TannerHollis/WS2812-Controller/Board_Design/Outputs/Board_Design_3D_Model.png

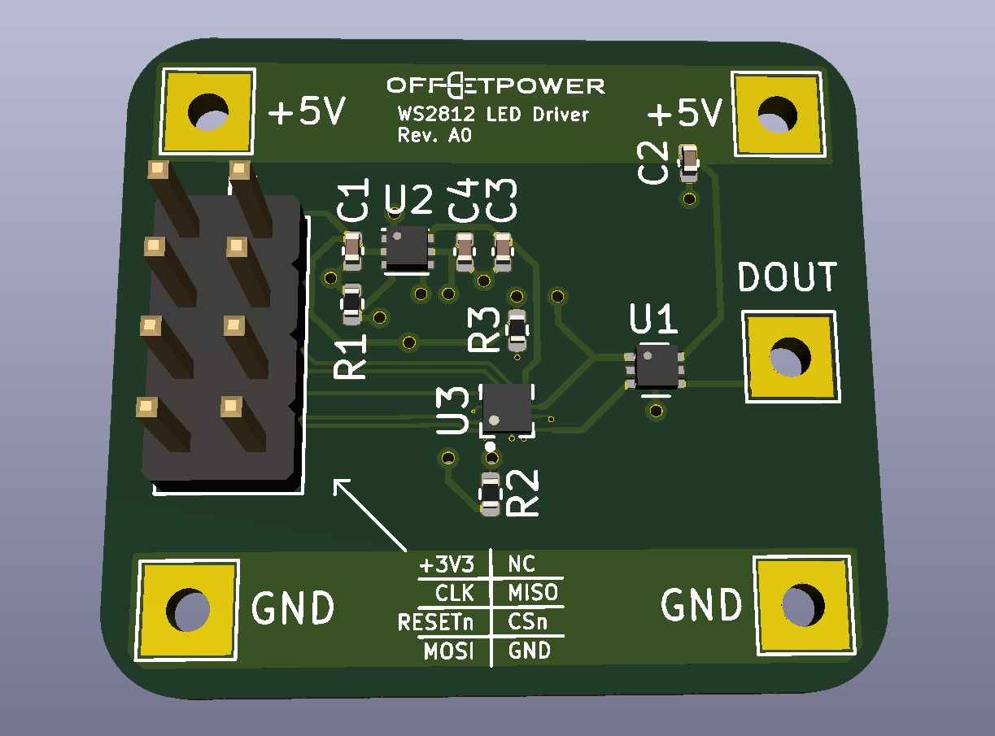
Board_Design/Outputs/Board_Design_3D_Model.png
