TannerHollis/WS2812-Controller/Images/ws2812_overview.png

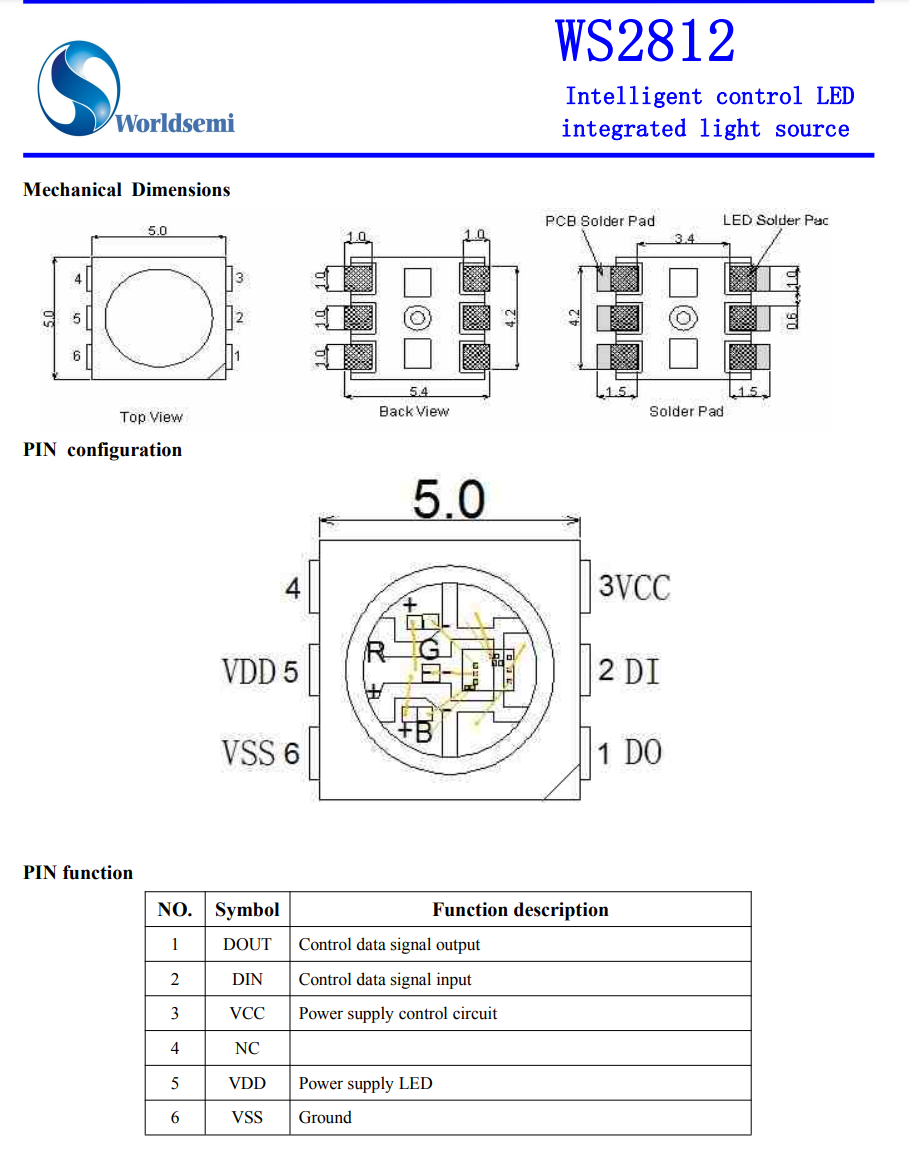
Images/ws2812_overview.png
