TannerHollis/WS2812-Controller/Board_Design/BOM-PCBWay.xlsx

 |  |  | WS2812 Driver BOM
Item # | *Designator | *Qty | Manufacturer | *Mfg Part # | Description / Value | *Package/Footprint | Type | Your Instructions / Notes
1 | C1, C3, C4 | 3 | Generic |  | 1U | C_0402_1005Metric | SMD
2 | C2 | 1 | Generic |  | 10U | C_0402_1005Metric | SMD
3 | J1 | 1 |  |  | 5Vin |  | SMD | DNP
4 | J2 | 1 |  |  | GNDin |  | SMD | DNP
5 | J3 | 1 |  |  | 5Vout |  | SMD | DNP
6 | J4 | 1 |  |  | DOUT |  | SMD | DNP
7 | J5 | 1 |  |  | GNDout |  | SMD | DNP
8 | J6 | 1 |  |  | INPUT |  | SMD | DNP
9 | J7, J8, J9, J10, J11, J12 | 6 |  |  | PogoPin |  | SMD | DNP
10 | R1, R2, R3 | 3 | Generic |  | 10K | C_0402_1005Metric | SMD
11 | U1 | 1 | 74LVC1T45Z6-7 | 74LVC1T45Z6-7 | Voltage Level Translator Bidirectional 1 Circuit 1 Channel - SOT-563 | SOT-563 | SMD
12 | U2 | 1 | Texas Instruments | TLV7111225DSER | Linear Voltage Regulator IC Positive Fixed 2 Output 200mA 6-WSON (1.5x1.5) | 6-WSON_1.5mmx1.5mm | SMD
13 | U3 | 1 | Lattice Semiconductor Corporation | ICE40UL640-SWG16ITR1K | series Field Programmable Gate Array (FPGA) IC 10 57344 640 16-XFBGA, WLCSP | 16-XFBGA, WLCSP | SMD
Need a quick and accurante quote? Need an efficient production? Please read SMT Ordering Necessary Files & Info in 1 minute. Thank you very much!
Click for Instructions on How to Create a BOM (https://www.pcbway.com/blog/PCB_Assembly/How_to_Build_a_BOM__Bill_Of_Materials_.html)
