TannerHollis/WS2812-Controller/Board_Design/Outputs/WS2812_Driver_Schematic.pdf

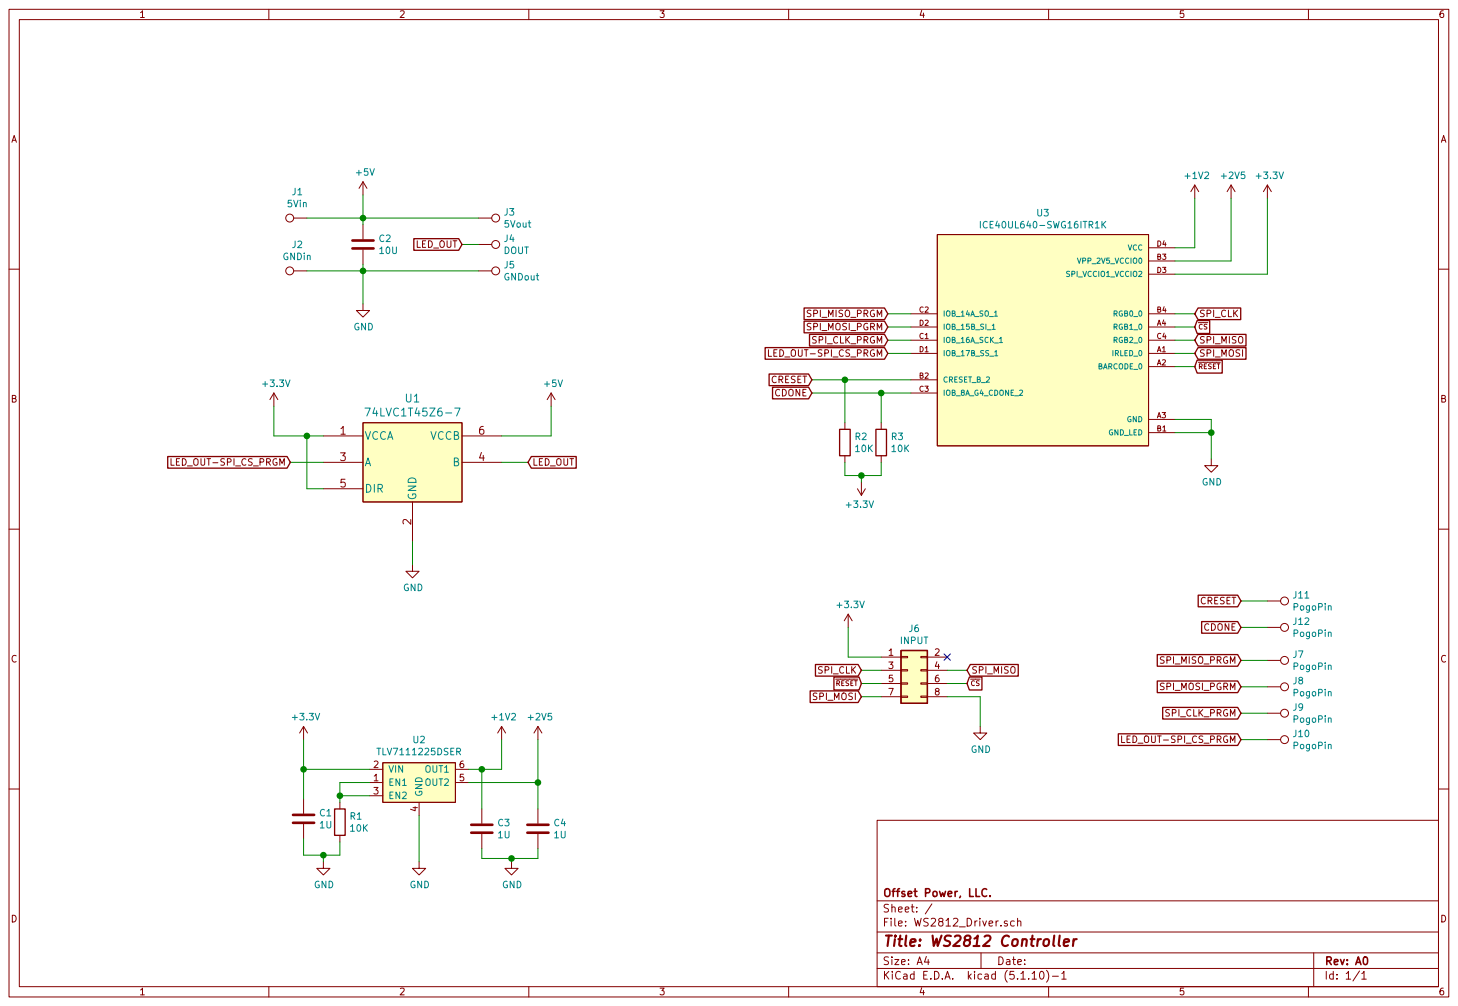
[picture p6: page 1]

File: WS2812_Driver.sch Sheet: / Offset Power, LLC.
