TannerHollis/WS2812-Controller/Board_Design/WS2812_Driver.kicad_pcb

## KiCad design Board_Design/WS2812_Driver.kicad_pcb (2021-12-08)

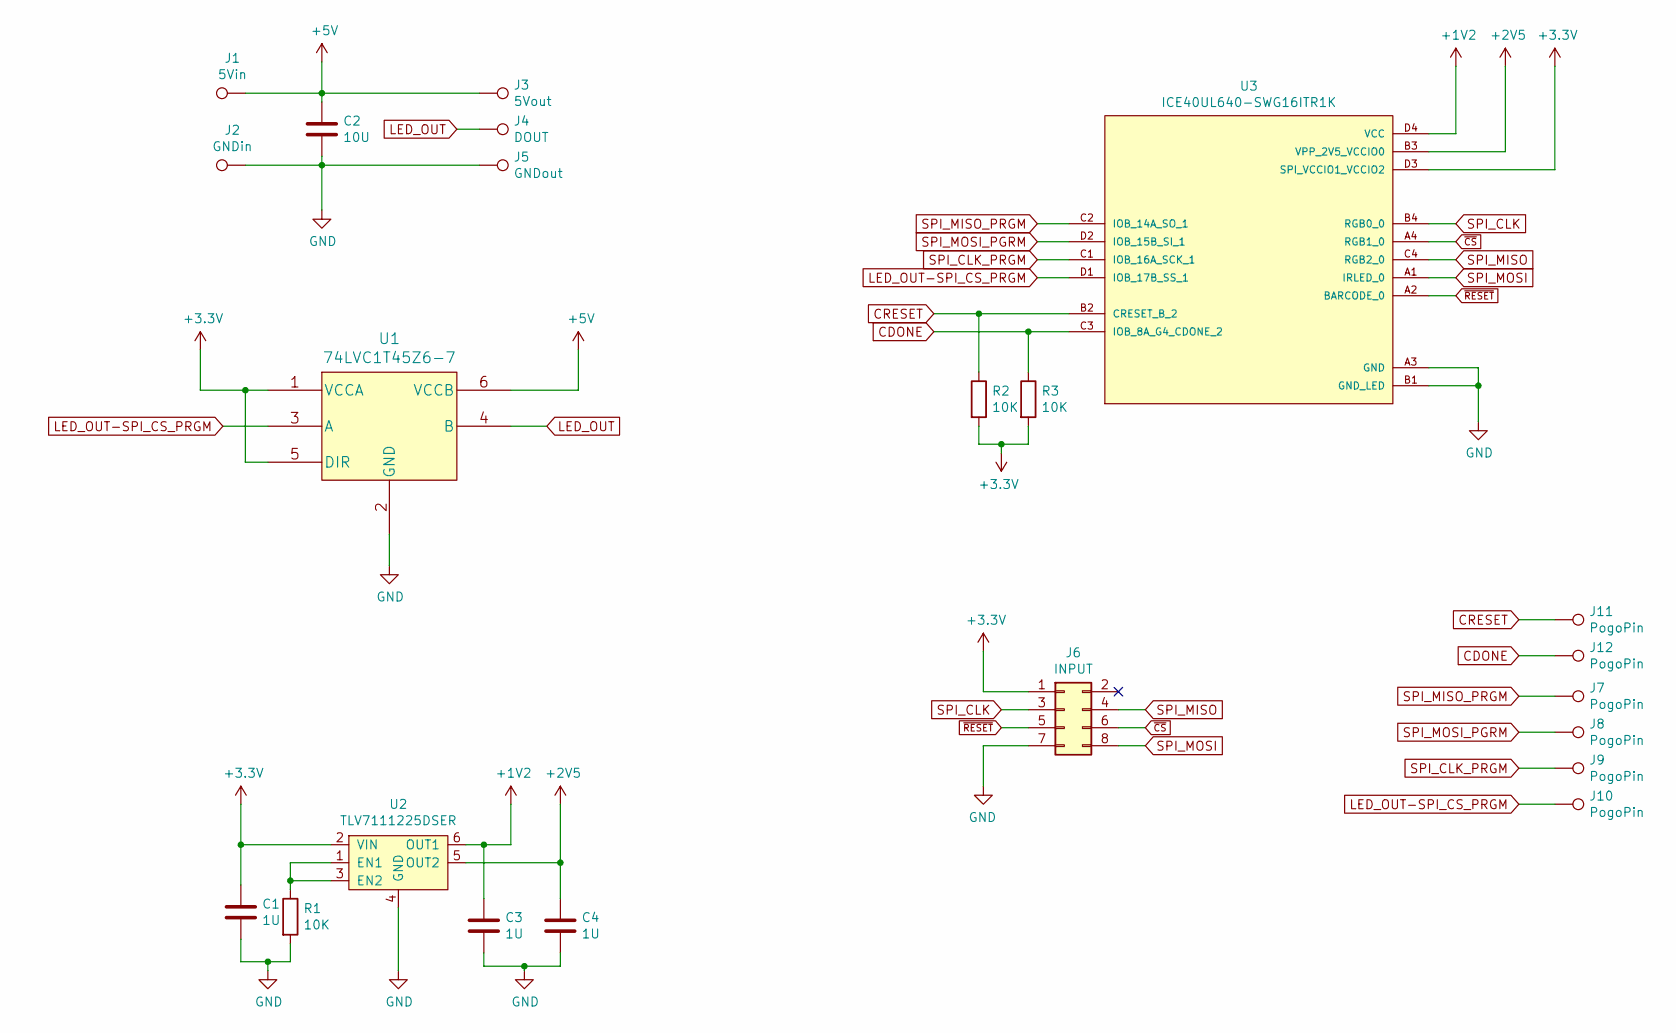
[picture p7: schematic WS2812_Driver.sch, WS2812 Controller]

Parts:
C1, C3, C4: 1U; C_0402_1005Metric
C2: 10U; C_0402_1005Metric
J1: 5Vin; TestPoint_THTPad_3.0x3.0mm_Drill1.5mm
J2: GNDin; TestPoint_THTPad_3.0x3.0mm_Drill1.5mm
J3: 5Vout; TestPoint_THTPad_3.0x3.0mm_Drill1.5mm
J4: DOUT; TestPoint_THTPad_3.0x3.0mm_Drill1.5mm
J5: GNDout; TestPoint_THTPad_3.0x3.0mm_Drill1.5mm
J6: INPUT; PinHeader_2x04_P2.54mm_Vertical
J7, J8, J9, J10, J11, J12: PogoPin; TestPoint_Pad_2.0x2.0mm
R1, R2, R3: 10K; R_0402_1005Metric
U1: 74LVC1T45Z6-7
U2: TLV7111225DSER; WSON-6_1.5x1.5mm_P0.5mm
U3: ICE40UL640-SWG16ITR1K; BGA16N35P4X4_140X140X49N

Connections:
+1V2: C3.1, U2.6 (OUT1), U3.D4 (VCC)
+2V5: C4.1, U2.5 (OUT2), U3.B3 (VPP_2V5_VCCIO0)
+3V3: C1.1, J6.1, R2.2, R3.2, U1.1 (VCCA), U1.5 (DIR), U2.2 (VIN), U3.D3 (SPI_VCCIO1_VCCIO2)
+5V: C2.1, J1.1, J3.1, U1.6 (VCCB)
CDONE: J12.1, R3.1, U3.C3 (IOB_8A_G4_CDONE_2)
CRESET: J11.1, R2.1, U3.B2 (CRESET_B_2)
GND: C1.2, C2.2, C3.2, C4.2, J2.1, J5.1, J6.7, R1.2, U1.2 (GND), U2.4 (GND), U3.A3 (GND), U3.B1 (GND_LED)
LED_OUT: J4.1, U1.4 (B)
LED_OUT-SPI_CS_PRGM: J10.1, U1.3 (A), U3.D1 (IOB_17B_SS_1)
unnamed: R1.1, U2.1 (EN1), U2.3 (EN2)
SPI_CLK: J6.3, U3.B4 (RGB0_0)
SPI_CLK_PRGM: J9.1, U3.C1 (IOB_16A_SCK_1)
SPI_MISO: J6.4, U3.C4 (RGB2_0)
SPI_MISO_PRGM: J7.1, U3.C2 (IOB_14A_SO_1)
SPI_MOSI: J6.8, U3.A1 (IRLED_0)
SPI_MOSI_PGRM: J8.1, U3.D2 (IOB_15B_SI_1)
~CS~: J6.6, U3.A4 (RGB1_0)
~RESET~: J6.5, U3.A2 (BARCODE_0)

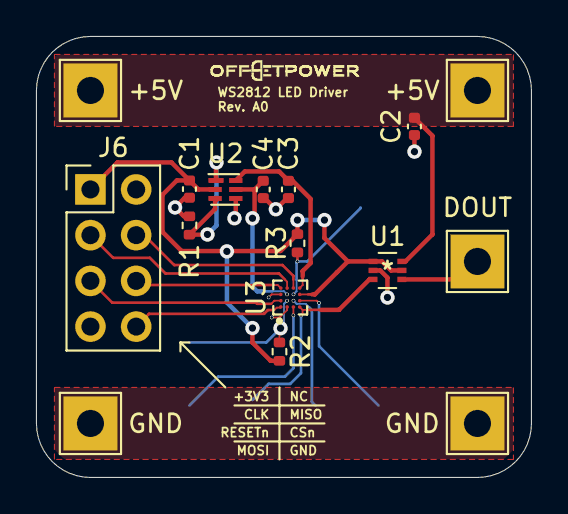
[picture p8: board WS2812_Driver.kicad_pcb from above]

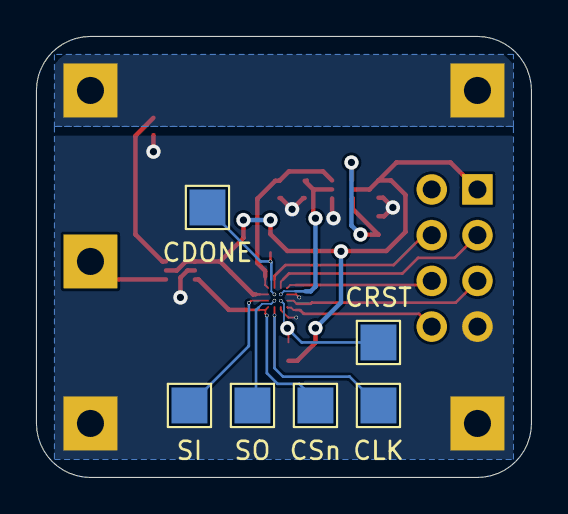
[picture p9: board WS2812_Driver.kicad_pcb from below]

Board: 2 copper layers, 27.5 x 24.5 mm, 22 parts (6 on the bottom side), 18 nets.
