TannerHollis/WS2812-Controller/(commit log)

2021-12-07 Device Overview
    Device Overview added. Modified top_tb for simulation. sb_translator has been modified for single-clock read/write operations.
2021-12-07 Added Board Design Files
    3d model + schematic capture
2021-12-07 Fixed sb_translator led counter
    erroneously added an additional count to the led counter on the third ram retrieval.
    [sb_translator.v]
2021-12-07 Implemented LED Driver Type - WIP
    Implemented LED Driver Type, not working for other types other than WS2812
    [ws2812.v]
2021-12-07 Uploaded Board Design Files
    Board Design Files have been uploaded
    [WS2812_Driver.kicad_pcb, WS2812_Driver.sch]
2021-12-08 Updated for DFR
    Updated design for more design-for-manufacturability.
    [BOM-PCBWay.xlsx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]
